EvgeniyRU/ZX_FDD_Emulator/Connection_diagram_buttons.png

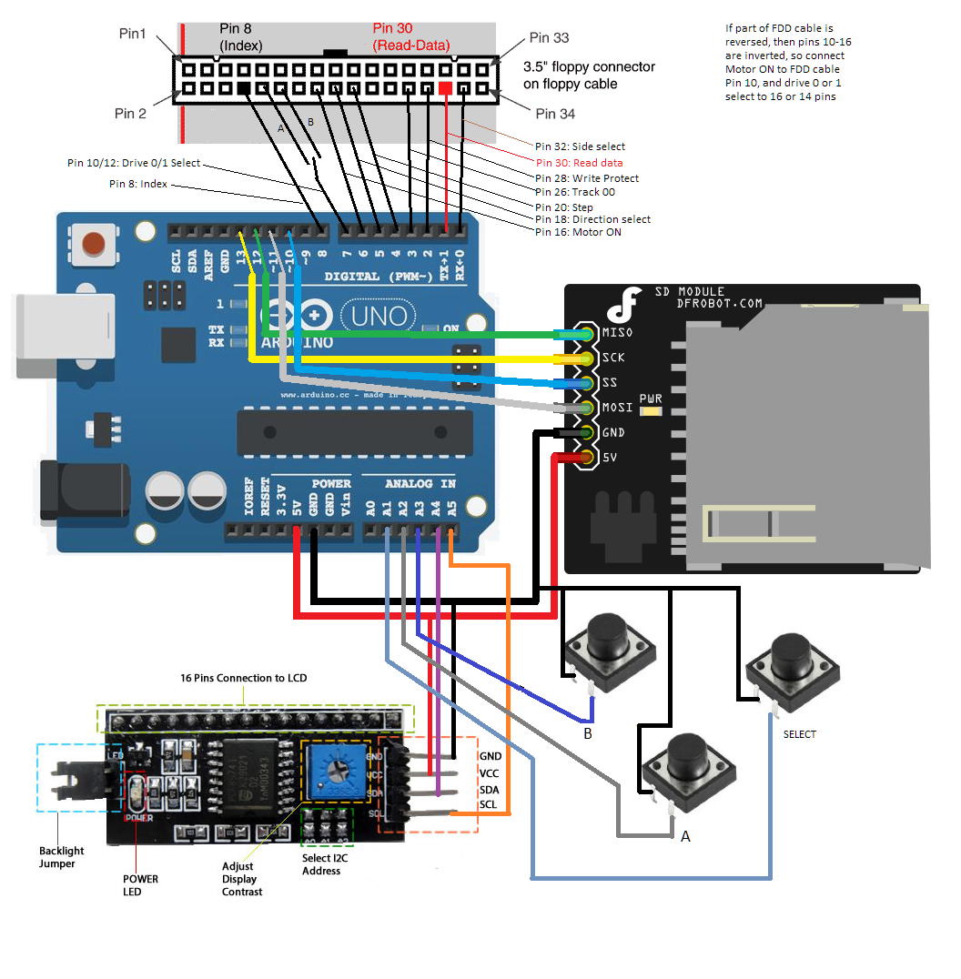
Connection_diagram_buttons.png
