EvgeniyRU/ZX_FDD_Emulator/Connection_diagram_encoder.png

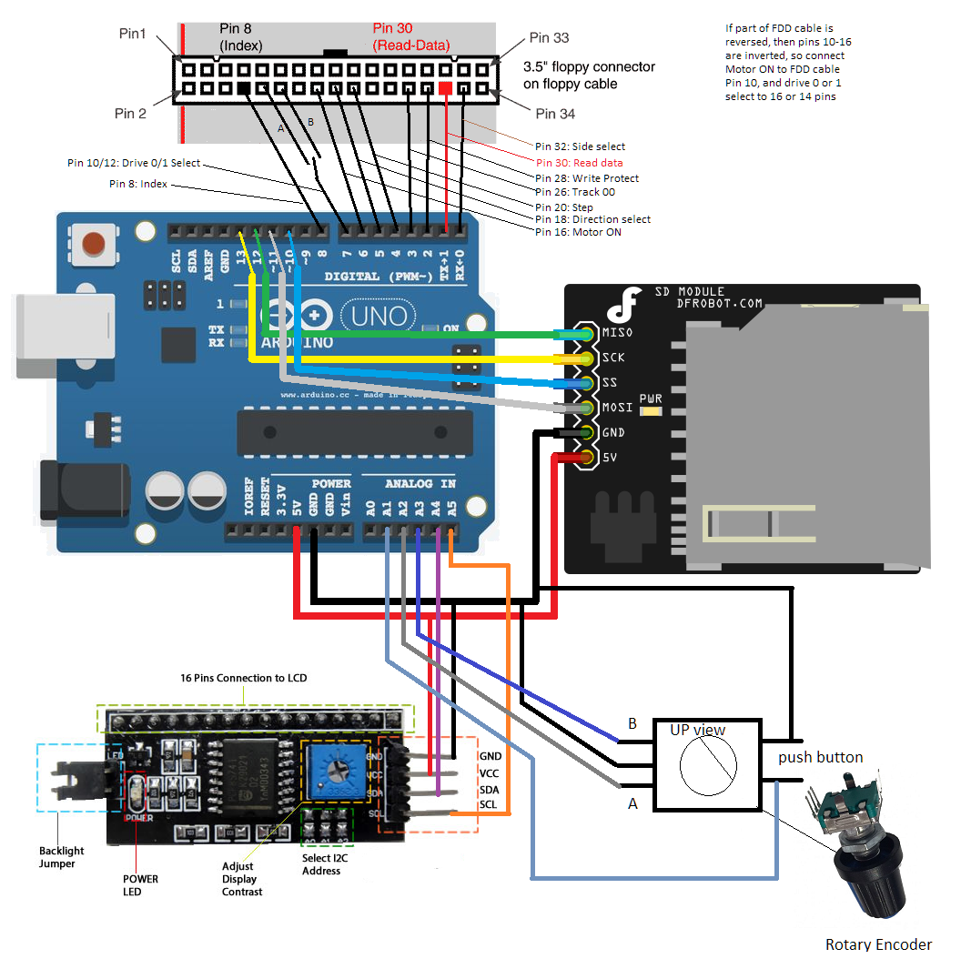
Connection_diagram_encoder.png
