EvgeniyRU/ZX_FDD_Emulator/Connection_diagram.png

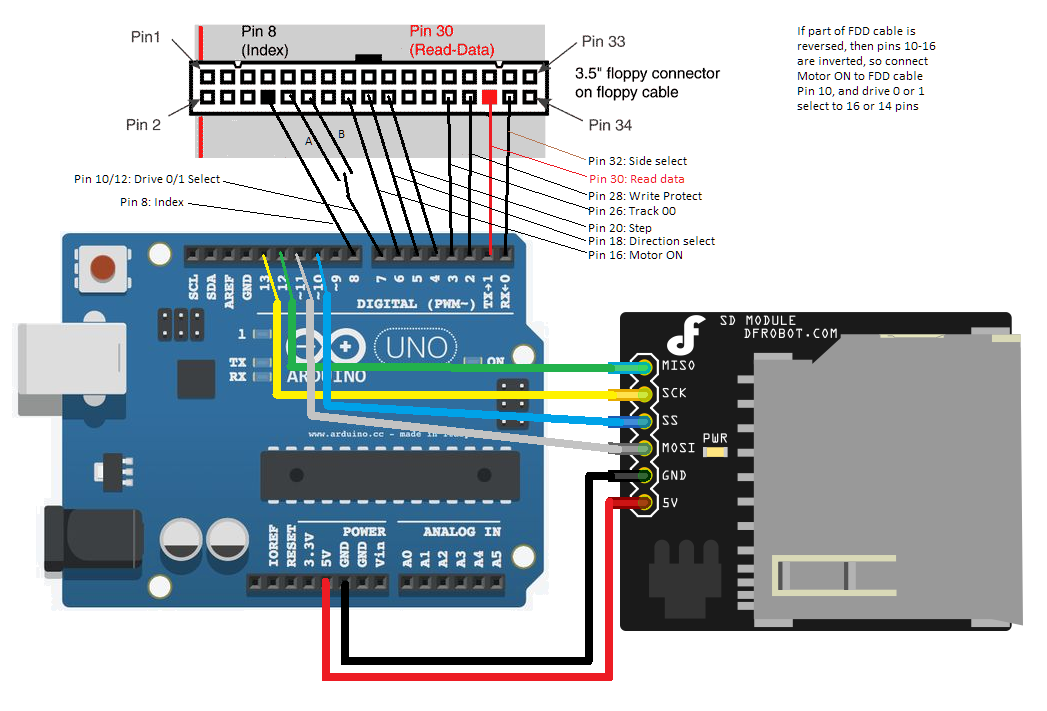
Connection_diagram.png
