EvgeniyRU/ZX_FDD_Emulator/(commit log)

2016-04-03 Some reverting and some optimization
    [FDD_Emulator.ino, Fat32Module.cpp, SDCardModule.cpp, SDCardModule.h]
2016-04-04 Fixed TRACK 1 problem + optimization
    [FDD_Emulator.ino, Fat32Module.cpp, SDCardModule.cpp]
2016-04-04 Better solution for track 1 problem
    [FDD_Emulator.ino, Fat32Module.cpp]
2016-04-04 FIXED Big problem with pin settings!!!
    [FDD_Emulator.ino]
2016-04-07 Even more optimization + cluster chain small fix
    [FDD_Emulator.ino]
2016-04-07 Change filename to correct open in Arduino IDE
    [Fat32Module.cpp, SDCardModule.cpp, ZX_FDD_Emulator.ino]
2016-04-08 Added Arduino IDE 1.0 support
2016-04-09 Some optimization, more correct STEP signal handling
    [SDCardModule.cpp, ZX_FDD_Emulator.ino]
2016-04-09 Fixed comments, improved TRK00, WP signals
    [ZX_FDD_Emulator.ino]
2016-04-10 Fixed small typo in max track calculation
    [ZX_FDD_Emulator.ino]
2016-04-10 Fixed small typo in cluster chain
    [ZX_FDD_Emulator.ino]
2016-04-14 More stable work! Correct Index generation, correct side handling, sector header on-the-fly generation
    [ZX_FDD_Emulator.ino]
2016-04-16 More stable work + MFM fix
    [ZX_FDD_Emulator.ino]
2016-04-18 More stable work
    Reverted for using 512 bytes buffer for more stable work, added check
    for read error to sd card module. And so on...
    [SDCardModule.cpp, SDCardModule.h, ZX_FDD_Emulator.ino]
2016-04-18 Some small fixes for stability
    [ZX_FDD_Emulator.ino]
2016-04-21 Finally, fixed step problems. Removed interleave for sectors.
    [ZX_FDD_Emulator.ino]
2016-04-21 More correct loading timings
    [ZX_FDD_Emulator.ino]
2016-04-22 New approach, only STEP interrupt
2016-04-22 Fixed some small typos
    [ZX_FDD_Emulator.ino]
2016-04-23 SUPER changes! Real MFM encoding at speed 1000kbps! Changed PCINT code to C again. Using falling edge for interrupt for 100% STEP detect.
2016-04-24 Added I2C LCD module and Rotary Encoder
2016-04-25 Final LCD version before adding encoder
2016-04-25 Lowered memory usage using very short MFM table
    [ZX_FDD_Emulator.ino]
2016-04-26 Initial Rotary Encoder support added
2016-04-26 Rotary Encoder debounce fix. Fixed move backward.
    [ZX_FDD_Emulator.ino]
2016-04-26 One more Rotary Encoder fix
    [ZX_FDD_Emulator.ino]
2016-04-26 Some more fixes :)
    [LCDModule.cpp, ZX_FDD_Emulator.ino]
2016-04-28 Revert "Fixed small typo"
    This reverts commit 828544ed80df5e83b751cf103d6e7ab6fa253efc.
    [ZX_FDD_Emulator.ino]
2016-04-28 First file back move fix
    [ZX_FDD_Emulator.ino]
2016-05-02 Small SD Card Module fix
    [Config.h, SDCardModule.cpp, ZX_FDD_Emulator.ino]
2016-05-02 More SD Card Module fix
    [SDCardModule.cpp]
2016-05-02 SD card speed fix
    [ZX_FDD_Emulator.ino]
2016-05-02 Some reverts in SD Card Module, Fixed open directory if no files
    [SDCardModule.cpp, ZX_FDD_Emulator.ino]
2016-05-10 Added 8 MHz oscillator support, Fixed Arduino 1.0 support
    [Config.h, LCDModule.h, ZX_FDD_Emulator.ino]
2016-05-10 Added EEPROM image name saving for using after reset. Hold button for > 3 sec for save.
    [Config.h, ZX_FDD_Emulator.ino]
2016-05-17 Removed 8MHz support, fixed problem with second FDD (disabling USART problem)
    [Config.h, LCDModule.h, ZX_FDD_Emulator.ino]
2016-05-18 Added buttons support (instead of encoder)
2016-05-18 Fixed some typos in buttons code
    [ZX_FDD_Emulator.ino]
2016-05-18 Buttons and encoder diagram
2016-09-01 Disabled interrupt if buttons selected instead of encoder + initial work with SCL support
2016-12-11 Some improvements in encoder part
2017-01-05 Improved buttons function, fixed initialization problem of some cards.
    [Fat32Module.cpp, LCDModule.cpp, SDCardModule.cpp]
2017-01-05 Removed busy symbol, added light on/off when device busy
2017-01-05 Fixed display flashing in some strange apps (FDD LED on real FDD flashing too)
    [LCDModule.cpp, LCDModule.h, ZX_FDD_Emulator.ino]
2017-04-14 Added pinchange support in LCD module, fixed readdir incorrect return type used for error detection. Thanks to Andy Karpov!
    [LCDModule.cpp, LCDModule.h, ZX_FDD_Emulator.ino]
2017-11-08 Fixed moving up in the directory
    [ZX_FDD_Emulator.ino]
2023-02-04 Update ZX_FDD_Emulator.ino
    Added Alex_LG corrections
    [ZX_FDD_Emulator.ino]
2023-02-04 LCD module fix
    Fixed address of LCD module, no need to multiply by 2 anymore
    [LCDModule.cpp, LCDModule.h]
